hayward2007/desky/README.md

# desky

책상 위에 놓는 5자유도(5-DOF) 로봇팔 프로젝트. End-effector에 **휴대폰을 장착**하는 것이 목표이며,
DYNAMIXEL AX-18A 서보 5개를 시리얼로 제어하고 URDF 기반 순기구학(FK)/역기구학(IK)을 제공한다.
휴대폰 카메라를 통해 **얼굴/손/몸(어깨) 인식**(셋 다 휴대폰 브라우저 자체 MediaPipe Tasks
Vision — 몸 인식은 얼굴 인식 실패 시 폴백), **문서 스캔/요약**, **음성 대화**(Gemini)도
지원한다. 손 인식/가위바위보 제스처는 켜져 있지만, 팔이 손 위치로 움직이는 것(추종)만
기본 꺼짐(`FollowControllerConst.HAND_FOLLOW_ENABLED`).

> **이 저장소는 두 갈래를 하나로 합친 통합본이다.**
> · 팔 추적 계열 — 얼굴/손 추적, 추종 컨트롤러, 두리번거리기 (`desky-develop`)
> · 웹 기능 계열 — 일정(캘린더), 조명 제어, 가위바위보 제스처, 라즈베리파이 서버
>   (`desky-new_mobile_1017ver`)
> 두 계열이 서로를 막지 않고 동시에 돌아가도록 기능마다 객체를 분리했다.
> 무엇이 어디서 왔고 어떤 충돌을 어떻게 풀었는지는 [docs/MERGE.md](docs/MERGE.md),
> 함수 단위 설명은 [docs/FUNCTIONS.md](docs/FUNCTIONS.md) 참고.

## 하드웨어 / 관절 구성

- 액추에이터: DYNAMIXEL **AX-18A** × 5 (Protocol 1.0), U2D2 등으로 시리얼 연결
- 관절 축 구성 (base → tip):

  | id | 관절 | 축 | 역할 |
  | -- | ---- | -- | ---- |
  | 1 | yaw | Z | 베이스 회전 (방위) |
  | 2 | roll | X | 팔 평면 롤 |
  | 3 | pitch | Y | 어깨 |
  | 4 | pitch | Y | 팔꿈치 |
  | 5 | pitch | Y | 손목 |

- 5-DOF이므로 위치(x, y, z) + 부분적인 자세만 도달 가능하며, 임의의 6-DOF pose는 만족할 수 없다.
- AX-18A 물리 각도 범위: **0~300°**, 내부 유닛값 범위 0~1023.

## 시작하기

### 요구 사항

- Python 3.x (기구학 모듈은 표준 라이브러리 위주라 버전에 크게 구애받지 않음)
- 의존성은 [requirements.txt](requirements.txt)에 정리돼 있다:
  - `dynamixel_sdk`, `python-dotenv` — 하드웨어 제어 시에만 필요
  - `matplotlib` — [kinematics/simulate.py](kinematics/simulate.py) 3D 프리뷰 전용
  - `flask`/`flask-sock`/`pyopenssl` — [src/app.py](src/app.py) 제어 대시보드 + 모바일 카메라 스트리밍
  - `opencv-python`/`numpy` — 문서 검출, 카메라 미리보기 창
  - `google-genai` — Gemini 채팅/요약/STT/문서 읽기 (`/api/ask`, `/api/scan/parse`)
  - 얼굴/손/몸(어깨) 인식 자체는 서버 의존성이 아니다 — 휴대폰 브라우저가 MediaPipe
    Tasks Vision을 자체적으로 돌린다(아래 "얼굴/몸/손 인식" 절 참고). `mediapipe`(Python)는
    이 프로젝트에 필요 없다.
- 기구학 패키지(`kinematics/kinematics.py`, `urdf_loader.py`)는 **표준 라이브러리만** 사용 — numpy 등 불필요

```bash
python -m venv .venv
source .venv/bin/activate
pip install -r requirements.txt
```

각 기능 객체(하드웨어, Gemini)는 자기 의존성이 없어도 예외 없이 만들어지고
"그 기능만 비활성" 상태가 된다 — 위 의존성을 전부 설치하지 않아도 앱 자체는 항상 뜬다.

### 환경 변수

프로젝트 루트에 `.env` 파일이 필요하다.

```env
# 하드웨어 (실제 서보 제어 시에만 필요)
DEVICE_NAME=tty01        # /dev/ 접두어는 제외하고 작성
BAUDRATE=1000000
PROTOCOL_VERSION=1.0

# Gemini (채팅/요약/STT/문서 읽기 — 없으면 해당 기능만 비활성)
GEMINI_API_KEY=
```

## 파일 구조

하드웨어 제어(`hardware/`), 기구학+3D 프리뷰(`kinematics/`), AI 인지 기능(`perception/`),
웹 제어 대시보드(`src/`)를 별도 패키지로 분리했다. 서로 독립적이며, `fundamental/`(로거 +
상수)만 전체가 공통으로 참조하는 루트 패키지다.

```text
desky/
├── main.py             # 진입점 — src.app.run() 실행. 하드웨어 유무 무관
├── fundamental/         # 전체 공통 루트 패키지
│   ├── logger.py           # 공통 [TAG] message 콘솔 로거
│   ├── const.py            # 프로젝트 전역 상수 (.env 로딩도 여기서)
│   └── network.py          # 이 PC의 LAN 주소 자동 탐지 + 시작 배너/대시보드 안내
├── requirements.txt    # 전체 의존성
├── hardware/           # 시리얼/서보 제어 (실제 하드웨어 필요)
│   ├── controller.py
│   └── actuator.py
├── kinematics/         # FK/IK + 3D 프리뷰 (하드웨어 불필요)
│   ├── kinematics.py
│   ├── urdf_loader.py
│   ├── simulate.py
│   ├── mujoco_sim.py
│   ├── find_joint_limits.py
│   ├── configure/
│   │   ├── desky.urdf
│   │   ├── joints.json
│   │   └── manifest.json
│   └── meshes/*.stl
├── perception/         # AI 인지 기능 (하드웨어 불필요, 카메라 프레임/랜드마크 입력)
│   ├── camera_geometry.py
│   ├── face_tracker.py     # 좌표 변환만 — 인식은 휴대폰이 함
│   ├── hand_tracker.py     # 좌표 변환만 — 인식은 휴대폰이 함
│   ├── follow_controller.py
│   └── gesture.py          # 가위바위보 판정 (병합: 웹 기능 계열)
├── src/                # Flask 제어 대시보드 + 모바일 카메라/음성/문서/일정/조명
│   ├── app.py              # DeskyApp — 조립만 담당
│   ├── arm_service.py      # 팔 상태·하드웨어·안전 검사 (병합 시 전역 제거)
│   ├── render.py           # ArmRenderer / ScenePreview (3D 그림)
│   ├── perception_loop.py  # 카메라→인식→추종→미리보기 루프
│   ├── gesture_bridge.py   # 제스처 → 폰 명령 + 조명
│   ├── api/
│   │   ├── arm.py          # 팔 제어 라우트 (병합 시 app.py에서 분리)
│   │   ├── gemini.py
│   │   ├── camera.py       # 양방향 소켓 (프레임·음성·랜드마크 ↔ 명령)
│   │   ├── scan.py
│   │   ├── calendar.py     # 일정 저장소 (병합: 웹 기능 계열)
│   │   ├── light.py        # 조명 프록시 — 중계/직접 호출 자동 선택 (병합: 웹 기능 계열)
│   │   └── relay.py        # 인터넷 중계(ntfy.sh)로 파이에 조명 명령 전달
│   ├── static/
│   │   └── theme.css       # 공통 디자인 시스템(색·글꼴·버튼) — 모든 페이지가 링크
│   └── templates/
│       ├── index.html
│       ├── mobile.html     # 두 계열 UI를 합친 페이지 (/mobile)
│       └── calendar.html   # 한 달 달력 전용 화면 (/calendar)
├── raspberry-server/   # 파이에서 따로 실행하는 서보(조명) 서버 (병합: 웹 기능 계열)
│   ├── server.py
│   └── templates/index.html
└── docs/
    ├── FUNCTIONS.md    # 모듈·함수 단위 설명서
    ├── MERGE.md        # 병합 내역과 충돌 해결 기록
    ├── FEATURES.md     # 기능별 구현 원리 정리(발표용 재료)
    └── PRODUCT.md      # "이 제품이 왜 필요한가" 발표 자료용 정리
```

| 파일 | 역할 |
|---|---|
| [main.py](main.py) | 진입점 — `src.app.run()` 호출(`python main.py` → `https://localhost:8000`). 하드웨어 없어도 실행됨 |
| [fundamental/logger.py](fundamental/logger.py) | `Logger` — 모든 모듈이 공유하는 `[TAG] message` 콘솔 로거 |
| [fundamental/const.py](fundamental/const.py) | 프로젝트 전역 상수(AX-18A 컨트롤 테이블 포함) — 각 모듈이 여기서 import해서 씀. `.env` 로딩도 이 파일 맨 위에서(늦게 로드하면 값이 무시된다) |
| [fundamental/network.py](fundamental/network.py) | 이 PC의 공유기 내부 IP를 찾아 폰이 입력할 URL을 만든다(`server_urls`, `startup_banner`) |
| [hardware/controller.py](hardware/controller.py) | 시리얼 포트/보드레이트 초기화, 저수준 read/write (`set_speed`, `set_goal_position`, `get_present_position`) |
| [hardware/actuator.py](hardware/actuator.py) | `Actuator`(모터 1개 추상화) + `ArmController`(FK/IK ↔ Actuator 연동) |
| [kinematics/kinematics.py](kinematics/kinematics.py) | FK/IK. `Arm`/`Joint` + 순수 파이썬 선형대수. 하드웨어 불필요 |
| [kinematics/urdf_loader.py](kinematics/urdf_loader.py) | `configure/desky.urdf`를 파싱해 `Arm` 생성 (`xml.etree`) |
| [kinematics/simulate.py](kinematics/simulate.py) | 인터랙티브 FK 슬라이더 + IK 입력 3D 미리보기 (matplotlib) |
| [kinematics/configure/desky.urdf](kinematics/configure/desky.urdf) | **로봇 구성의 단일 소스 오브 트루스** (URDF, XML) |
| [perception/face_tracker.py](perception/face_tracker.py) | `FaceTracker` — **인식은 안 함**, 휴대폰이 보낸 얼굴 랜드마크를 3D 월드 좌표로 변환/시각화만 + `FaceFollower` |
| [perception/body_tracker.py](perception/body_tracker.py) | `BodyTracker` — **인식은 안 함**(얼굴 인식 실패 시 폴백), 휴대폰이 보낸 어깨 랜드마크를 3D 월드 좌표로 변환/시각화만 + `BodyFollower` |
| [perception/hand_tracker.py](perception/hand_tracker.py) | `HandTracker` — **인식은 안 함**, 휴대폰이 보낸 손 랜드마크를 end-effector FK 기반 3D 월드 좌표로 변환/시각화만 + `HandFollower` |
| [perception/follow_controller.py](perception/follow_controller.py) | `FollowController` — 얼굴>몸>손>idle 우선순위 + idle 두리번 상태 머신 |
| [perception/gesture.py](perception/gesture.py) | `GestureRecognizer` — 손 랜드마크로 가위/바위/보 판정, 확정 시 1회만 발동(엣지 트리거) |
| [src/app.py](src/app.py) | `DeskyApp` — **조립만** 담당(서비스 생성 + 라우트 등록 + 실행). 페이지 `/`, `/mobile` |
| [src/arm_service.py](src/arm_service.py) | `ArmService` — 팔 모델·하드웨어·관절각 캐시·자기충돌 안전 검사. 병합 전 `app.py` 전역이던 것 |
| [src/render.py](src/render.py) | `ArmRenderer`(자세→PNG) / `ScenePreview`(로컬 3D 창 재사용) |
| [src/perception_loop.py](src/perception_loop.py) | `PerceptionLoop` — 프레임→얼굴/손/몸→추종 명령→제스처→미리보기. 세 가지 주기를 따로 관리 |
| [src/gesture_bridge.py](src/gesture_bridge.py) | `GestureBridge` — 확정된 제스처를 폰 명령(소켓)과 조명 제어로 배선 |
| [src/api/arm.py](src/api/arm.py) | `ArmAPI` — 팔 제어 라우트(`/api/status`, `/fk`, `/ik`, `/render`, `/goto_*`) |
| [src/api/gemini.py](src/api/gemini.py) | `Gemini` — 채팅/요약(`/api/ask`), STT, 문서 이미지 글자 읽기 |
| [src/api/camera.py](src/api/camera.py) | `Camera` — `/ws/camera` **양방향**: 폰→서버(프레임·음성·손/얼굴/몸 랜드마크), 서버→폰(transcript·제스처 명령) |
| [src/api/scan.py](src/api/scan.py) | `ScanAPI` — `POST /api/scan/parse` 하나뿐. 라이브 프레임을 통째로 Gemini에 보내 읽는다(문서 검출/선택 없음) |
| [src/api/calendar.py](src/api/calendar.py) | `Calendar` — 일정 조회/추가/삭제(`/api/calendar/*`), `calendar_events.json`에 영속화 |
| [src/static/theme.css](src/static/theme.css) | 공통 디자인 시스템 — 색 토큰, 글꼴, 칩/큰버튼/입력 공통 스타일. 색 하나만 여기서 바꾸면 전 화면이 함께 바뀐다 |
| [src/templates/calendar.html](src/templates/calendar.html) | 일정 화면(`/calendar`) — 한 달 달력 + 고른 날의 일정 목록·추가 |
| [src/api/light.py](src/api/light.py) | `Light` — 조명 스위치 서보 프록시(`/api/light`). 폰의 혼합 콘텐츠 차단을 서버 경유로 우회. `Relay`가 켜져 있으면 인터넷 중계로, 아니면 직접 HTTP로 파이를 부른다 |
| [src/api/relay.py](src/api/relay.py) | `Relay` — PC와 파이가 서로 다른 공유기에 있어도 `ntfy.sh` 공개 중계소로 조명 명령을 전달(`DESKY_RELAY_TOPIC` 설정 시에만 활성) |
| [raspberry-server/server.py](raspberry-server/server.py) | 파이에서 **따로** 실행하는 서보 제어 서버 (`/api/press`) + `RelayClient`(중계 구독, 로컬 HTTP와 동시에 실행) |
| [src/templates/index.html](src/templates/index.html) | 대시보드 UI (위치/관절 입력, 상태, 카메라 프리뷰, 폰 접속 LAN 주소 카드) |
| [src/templates/mobile.html](src/templates/mobile.html) | 팔에 장착된 휴대폰에서 여는 페이지 — 카메라 스트리밍, Gemini 채팅/요약, 음성 대화·명령, 문서 스캔 UI |

> **항상 저장소 루트에서 실행할 것** (`python main.py`, `python -m kinematics.kinematics`,
> `python -m kinematics.simulate`, `python -m src.app` 등). 하위 폴더의 파일을 직접
> 실행하면(`python kinematics/kinematics.py`) 루트가 `sys.path`에 없어 `fundamental` 임포트가
> 깨진다.

### 계층 구조

```text
main.py
  └─ src.app.DeskyApp                       # 조립만: 서비스 생성 + 라우트 등록 + 실행
       ├─ src.arm_service.ArmService ── hardware.actuator.ArmController ── Actuator ×5 ── Controller ── fundamental.const.AX_18A + dynamixel_sdk
       │                                   └─ kinematics.kinematics.Arm ◄── kinematics.urdf_loader.load_arm()
       ├─ src.render.ArmRenderer            # URDF 기하 1회 파싱 → PNG / 3D 창
       ├─ src.api.arm.ArmAPI                # /api/status, /fk, /ik, /render, /goto_*
       ├─ src.api.gemini.Gemini             # /api/ask, STT, 문서 읽기
       ├─ src.api.camera.Camera ── Gemini   # /ws/camera (양방향)
       ├─ src.api.scan.ScanAPI ── Gemini     # 라이브 프레임 통째로 (문서 검출 없음)
       ├─ src.api.calendar.Calendar         # /api/calendar/*  (웹 기능 계열)
       ├─ src.api.light.Light ── Relay ──HTTP 또는 인터넷 중계──▶ raspberry-server  (웹 기능 계열)
       ├─ src.gesture_bridge.GestureBridge ── perception.gesture + Camera + Light
       └─ src.perception_loop.PerceptionLoop
            ├─ perception.face_tracker.FaceTracker        (폰이 보낸 랜드마크 → 월드 좌표)
            ├─ perception.body_tracker.BodyTracker        (폰이 보낸 랜드마크 → 월드 좌표, 얼굴 폴백)
            ├─ perception.hand_tracker.HandTracker        (폰이 보낸 랜드마크 → 월드 좌표)
            ├─ perception.follow_controller.FollowController  (얼굴 > 몸 > 손 > idle)
            └─ src.render.ScenePreview
```

병합 후 두 계열의 **유일한 접점**은 `Camera`(소켓)와 `ArmService`(팔 상태) 둘뿐이고,
둘 다 락으로 감싸져 있어 웹 요청 스레드와 카메라 루프가 안전하게 공유한다.

`main.py`는 `src.app`을 임포트해 실행하는 얇은 launcher다 — 실제 초기화(하드웨어, Gemini)는
`src/app.py` 쪽에서 일어난다 (하드웨어/Gemini가 없으면 실패를 잡아 "미연결/미구성" 상태로
대체 — 아래 절 참고).

`ArmController`가 FK/IK(`kinematics.Arm`)와 실제 `Actuator` 5개를 연결한다. `Actuator.id`
(DYNAMIXEL id)와 URDF `<dynamixel id="">`가 일치하는 조인트끼리 매칭하므로, 생성자에 넘기는
`actuators` 리스트는 순서에 상관없다.

```python
from hardware.controller import Controller
from hardware.actuator import Actuator, ArmController

controller = Controller()
actuators = [Actuator(id=i, model="AX-18A", controller=controller) for i in range(1, 6)]
arm_ctrl = ArmController(actuators)                  # arm=load_arm() 기본값 사용

q, ok = arm_ctrl.goto_position((0.3, 0.05, 0.15))    # IK 계산 → 5개 서보에 goto() 디스패치
pos = arm_ctrl.get_position()                         # 5개 서보 현재각 read → FK로 위치 계산
```

- `goto_position`은 IK가 수렴하지 않으면(`converged=False`) 서보를 움직이지 않는다.
- `get_position`은 액추에이터 중 하나라도 `None`을 반환하면(통신 실패) 전체 결과도 `None`.

## 웹 제어 대시보드 (하드웨어 없어도 실행됨)

```bash
python -m venv .venv && source .venv/bin/activate && pip install -r requirements.txt   # 최초 1회
python main.py   # 저장소 루트에서 실행, https://localhost:8000
# 또는 동일하게: python -m src.app
```

`src/app.py`는 시작 시 `Controller()`로 시리얼 포트를 열고 액추에이터 5개 + `ArmController`를
구성하려고 시도한다 — **성공하면** 실제 서보를 제어할 수 있고, **실패하면**(장치 없음,
`.env` 없음, `dynamixel_sdk`/`python-dotenv` 미설치 등) 예외를 잡아 "no hardware connected"
상태로 대시보드가 그대로 뜬다(아래 참고). 하드웨어가 연결되어 있으면 브라우저 대시보드에서:

- 관절별 서보각 슬라이더 → FK 미리보기가 실시간으로 갱신, "Move actuators"로 실제 이동
- 목표 위치 (x, y, z, 미터) 입력 → IK 계산, 슬라이더가 해로 스냅
- 1.5초마다 현재 위치를 폴링해 표시
- 팔에 장착된 휴대폰이 `/mobile`에서 스트리밍 중이면 카메라 프리뷰도 함께 표시(아래 참고)

라우트: `GET /`(대시보드), `GET /mobile`, `GET /api/status`, `POST /api/fk`, `POST /api/ik`,
`POST /api/render`, `POST /api/goto_position`, `POST /api/goto_joints`, `POST /api/goto_joint`,
`WS /ws/camera`, `GET /api/camera/latest.jpg`, `GET /api/camera/status`, `POST /api/ask`,
`POST /api/scan/parse`, `GET /api/network`(폰이 입력할 LAN 주소 목록).

> **참고:** `app.run(..., port=8000, debug=False, threaded=True, ssl_context="adhoc")`로
> 고정되어 있다.
>
> - 포트 5000이 아니라 8000을 쓰는 이유는 macOS AirPlay Receiver가 5000번을 기본으로 점유하기
>   때문.
> - `debug=False`인 이유는 Flask 리로더가 모듈을 다시 임포트하면 시리얼 포트가 두 번 열리기
>   때문 — `debug=True`로 바꾸지 말 것.
> - `threaded=True`인 이유는 `/ws/camera` 웹소켓이 세션 내내 연결을 유지해서, 스레드 하나로만
>   서빙하면 다른 HTTP 요청이 막히기 때문.
> - `ssl_context="adhoc"`인 이유는 아래 모바일 카메라 스트리밍 절 참고.

### 모바일 카메라 스트리밍 (`/mobile`, `/ws/camera`)

팔 끝(end-effector)에 장착된 휴대폰에서 `https://<이 서버의 LAN IP>:8000/mobile`을 열면:

1. "Start camera + streaming" 버튼을 누르면 `getUserMedia({video: {facingMode: {exact: "user"}},
   audio: false})`로 전면 카메라 권한을 요청한다(마운트 구조상 전면 카메라만 써야 하므로
   `exact`로 강제 — 전면 카메라가 없으면 후면으로 조용히 넘어가지 않고 바로 에러가 난다. 음성
   대화는 브라우저 내장 STT가 별도로 마이크 권한을 요청한다).
2. 승인되면 `<video>`로 로컬 프리뷰를 띄우고, 200ms(약 5fps)마다 `<canvas>`에 프레임을 그려
   `canvas.toBlob('image/jpeg')`로 JPEG를 만들어 `wss://<host>/ws/camera`로 바이너리 그대로
   전송한다. 프레임마다 완결된 JPEG라서 서버가 컨테이너/코덱을 재조립할 필요가 없다.

서버([src/api/camera.py](src/api/camera.py))는 `flask_sock.Sock`으로 `/ws/camera`를 raw
WebSocket으로 처리한다:

- 들어오는 바이너리가 JPEG면 최신 프레임으로 저장(락으로 보호), 프레임 수·마지막 수신 시각·
  연결된 클라이언트 수도 함께 추적. WebM/Opus 음성 클립이면 Gemini로 받아쓴다(레거시 경로 —
  현재 UI는 브라우저 내장 STT를 쓰므로 기본적으로는 이 경로를 타지 않는다).
- `GET /api/camera/latest.jpg` — 최신 프레임을 `image/jpeg`로 반환(아직 없으면 404).
- `GET /api/camera/status` — `{streaming, clients, frame_count, age_seconds}`.
- 대시보드(`/`)는 `/api/camera/status`를 0.5초마다 폴링하고, 스트리밍 중이면 이미지 태그를
  갱신해 실시간처럼 보여준다(진짜 스트리밍이 아니라 폴링 기반 프리뷰 — 데모 목적으로는 충분).

**HTTPS가 필요한 이유:** 브라우저는 secure context(HTTPS 또는 `localhost`)에서만
`getUserMedia`/음성 인식을 허용한다. 휴대폰은 LAN IP로 접속하므로 `localhost`가 아니어서
HTTPS가 필수다. `ssl_context="adhoc"`(pyOpenSSL)으로 실행할 때마다 자체 서명 인증서를 즉석에서
만들어 쓰므로 브라우저가 "안전하지 않음" 경고를 한 번 띄운다 — 데스크톱 대시보드, 모바일
페이지 둘 다에서 "고급 → 계속 진행"으로 넘어가야 한다.

### 얼굴/몸/손 인식 (`perception/face_tracker.py`, `perception/body_tracker.py`, `perception/hand_tracker.py`)

**얼굴/손/몸(어깨) 인식은 전부 휴대폰이 한다** — 컴퓨터 하나가 여러 모델 추론을 다
처리하면 매 프레임 렌더링/하드웨어 제어까지 합쳐서 휴대폰이 실제로 보내는 프레임레이트
(~20fps)를 못 따라갔고, 서버가 받는 프레임은 JPEG 압축 + 다운스케일 때문에 화질이 떨어져
인식 자체가 잘 안 되는 문제도 있었다(특히 얼굴). 그래서 `mobile.html`이 휴대폰 브라우저에서
직접 MediaPipe Tasks Vision(`HandLandmarker` + `FaceLandmarker` + `PoseLandmarker`)을
돌려 랜드마크만 `/ws/camera`로 보내고, 서버는 그 좌표를 3D 월드 좌표로 변환만 한다 —
mediapipe(Python)는 이 프로젝트에 필요 없다. 카메라 창에 얼굴/손/몸 골격을 오버레이하고,
3D 씬 창에도 추정 월드 좌표를 함께 그린다. 휴대폰 카메라가 end-effector에 달려 있다는
전제로, 기준자(손목~엄지CMC 3.5cm, 눈 바깥쪽 끝 사이 9cm, 양쪽 어깨 사이 0.4m)와 화면상
크기로 카메라까지 거리를 역산(핀홀 모델)한 뒤 현재 end-effector의 FK 변환행렬로 랜드마크를
월드 좌표에 올린다. 실제 캘리브레이션한 값이 아니므로 거리는 추정치다. 휴대폰이
HandLandmarker/FaceLandmarker/PoseLandmarker 중 하나를 못 띄우면(오프라인, CDN 접근 불가
등) 그 오버레이만 빠진다 — 서로 독립적으로 실패하며, 어느 쪽이든 카메라 창은 그대로 뜬다.
손 인식/가위바위보 제스처는 켜져 있다(`mobile.html`의 `HAND_TRACKING_ENABLED = true`) —
대신 팔이 손 위치로 움직이는 것(추종)만 서버 쪽
`FollowControllerConst.HAND_FOLLOW_ENABLED = False`로 기본 꺼져 있다. 손 인식 자체를
끄고 싶으면 `HAND_TRACKING_ENABLED`(둘 다 함께 꺼짐), 추종만 끄고 싶으면(제스처는 유지)
`HAND_FOLLOW_ENABLED`.

**몸(어깨) 인식은 얼굴 인식 실패 시 폴백이다** — 옆모습, 고개를 돌린 경우 등 얼굴이 안
잡힐 때도 어깨는 보이는 경우가 많다는 점을 이용한다. 처음엔 서버가 mediapipe Pose로
직접 돌렸지만(사용자가 명시적으로 요청했던 부분), 얼굴/손과 같은 이유로 이후 휴대폰으로
옮겼다. 양쪽 어깨 중점을 몸 중심으로 쓰고 어깨 너비(0.4m 가정)로 깊이를 추정하는 것
말고는 얼굴/손과 같은 핀홀 방식이고, 추종 로직(화면 오프셋 → yaw 회전 + 높이 이동)도
`FaceFollower`와 동일하다.

얼굴 > 몸 우선순위는 "보이느냐"가 아니라 **거리 기준**이다 — 얼굴까지 거리가
`FollowControllerConst.FACE_BODY_SWITCH_DISTANCE_M`(기본 1m)보다 가까우면 얼굴을, 멀면
(안 보여도) 몸을 추적한다. 멀리서는 얼굴 랜드마크가 화면에서 작아져 노이즈에 약해지는데
어깨는 상대적으로 안정적으로 잡히기 때문.

이 거리 경계에는 **히스테리시스**(`FACE_BODY_SWITCH_HYSTERESIS_M`, 기본 0.15m)를 둔다 —
경계 하나만 쓰면 깊이 추정치가 그 근처에서 맴돌 때(랜드마크 잔떨림, 고개를 살짝 돌리는
정도로도 흔함) 판정이 프레임마다 뒤집혀서, 디바운스가 있어도 몇 초에 한 번씩 계속
얼굴<->몸을 갈아타며 위아래로 훑는 진동이 남았다. 그래서 지금 얼굴을 보는 중이면 거리가
`FACE_BODY_SWITCH_DISTANCE_M + HYSTERESIS`보다 멀어져야 몸으로, 몸을 보는 중이면 그보다
`- HYSTERESIS`만큼 가까워져야 얼굴로 돌아온다(판정에 쓰는 얼굴 깊이 자체도
`FACE_DEPTH_SMOOTHING`으로 별도 평활).

대상 전환은 **디바운스**된다(`TARGET_SWITCH_TIMEOUT_S`, 기본 0.5초) — 인식이 한두
프레임 흔들릴 때마다 바로 갈아타면 코끝과 어깨 중점의 화면상 높이 차이 때문에 팔이
위아래로 계속 흔들리는 문제가 있어서, 새 후보가 그 시간 동안 끊기지 않고 이어져야
실제로 전환한다. **단 지금 얼굴을 추적 중일 때는** 이 시간 대신 더 긴
`FACE_LOST_GRACE_S`(기본 1.5초)를 쓴다 — 얼굴 인식은 고개를 살짝 돌리는 정도로도
한두 프레임 끊기는 일이 흔해서, 0.5초로는 몸으로 너무 쉽게 넘어가 버렸다. `FollowController`
우선순위는 얼굴 > 몸 > 손 > idle(히스테리시스 + 디바운스 반영).

**몸을 추적하며 멈춰 있으면 한 번 살짝 들어 올려 얼굴을 다시 찾아본다** — 몸(어깨)
추적 중 화면 오프셋이 데드존 안이라 팔이 `FACE_REACQUIRE_STILL_S`(기본 2초) 동안
가만히 있었고 거리가 가까우면(`FACE_BODY_SWITCH_DISTANCE_M` 이내), 팔을
`FACE_REACQUIRE_HEIGHT_STEP_M`만큼 한 번 들어 올려 얼굴이 화면에 걸리는지 시도해
본다 — 어깨 기준으로 카메라를 맞추면 얼굴이 화면 위쪽 경계 밖에 있을 수 있어서다.
들어 올린 뒤 `FACE_REACQUIRE_SUPPRESS_S` 동안은 `BodyFollower`가 다시 낮추지
못하게 붙잡아 두고, 몸 추적 세션당 한 번만 시도한다.

**전원을 켠 직후에는 카메라 연결과 무관하게 곧장 IDLE_POSITION으로 이동한다** —
`PerceptionLoop.__init__()`이 하드웨어가 연결돼 있으면 그 자리에서 바로 이동
명령을 낸다. 그 외 모든 이동은 카메라 프레임이 들어와야 도는
`FollowController.next_command()`를 거치므로, 이 이동만 따로 두지 않으면 폰이
아직 한 번도 연결 안 됐을 때 팔이 이전 세션 자세 그대로 계속 있게 된다.

**그 다음 `STARTUP_IDLE_S`(기본 3초) 동안은 무조건 idle을 유지한다** —
`FollowController`가 만들어진 시점부터 이 시간 동안은 얼굴/몸/손이 보여도 전부
무시한다. 카메라가 연결된 뒤에도 곧장 추적을 시작하지 않고 한 박자 쉬게 하는
용도로, 전원을 켜자마자 사람이 이미 카메라 앞에 있어도 그 순간 곧바로 팔이 홱
움직이지 않게 한다. 또한 `FollowController.next_command()`는 `camera_connected`
인자를 받는데(`PerceptionLoop`가 `Camera.connected()`로 넘겨준다), 이게 False면
idle이어도 두리번거리기(좌우로 흔드는 룩어라운드)는 시작하지 않고 IDLE_POSITION에서
가만히 대기만 한다 — 웹소켓은 붙어서 프레임이 흐르고 있어도 `mobile.html`의
Hand/Face/PoseLandmarker가 아직 로드 중이라 랜드마크를 한 번도 못 보낸 구간이
있는데, 그 구간을 "폰이 진짜 연결됐다"로 치지 않기 위해 `Camera.connected()`는
소켓 연결 + 랜드마크 최초 수신을 모두 요구한다.

### Gemini 채팅/요약/STT/문서 읽기 (`/mobile`, `POST /api/ask`)

[src/templates/mobile.html](src/templates/mobile.html)에 "Ask Gemini" 섹션이 있다
(대시보드 `/`에는 없음) — 텍스트를 입력하고 Chat/Summarize 모드를 골라 `POST /api/ask`로
보낸다. [src/app.py](src/app.py)는 하드웨어와 똑같은 패턴으로 시작 시 Gemini 클라이언트 구성을
시도하고, 실패해도 앱은 계속 뜬다:

- `GEMINI_API_KEY` 환경 변수(`.env`에 넣으면 `python-dotenv`가 있을 때 자동 로드됨)와
  `google-genai` 패키지가 있어야 `Gemini.configured`가 `True`가 된다.
- 실패하면(키 없음, 패키지 미설치 등) `Gemini.error`에 원인 저장 — `/mobile`은 "⚠ Gemini not
  configured — <원인>" 배너를 띄우고 입력/버튼을 비활성화한다.
- 답은 음성으로 그대로 읽히는 것을 전제로 짧고(100자 이내), 목록·기호·마크다운 없이 말하듯
  쓰도록 지시돼 있다.
- `POST /api/ask` — 바디 `{"text": "...", "mode": "chat"|"summary"}`. `mode`에 따라 다른
  system instruction을 사용해 Gemini를 호출한다.
  - 미구성 시 `503 {"error": "Gemini not configured: ..."}`.
  - `text` 누락 시 `400 {"error": "text is required"}`.
  - Gemini 호출 자체가 실패하면 `502 {"error": "..."}`.
  - 성공 시 `200 {"answer": "..."}`.

### 문서 스캔 · 요약 (`/mobile`, `POST /api/scan/parse`)

`/mobile`의 "문서 스캔" 버튼(또는 음성 "스캔해줘", 가위 제스처)을 누르면 지금
라이브로 들어오고 있는 카메라 프레임을 **통째로** Gemini에게 보내 본문을
읽는다 — `mode="text"`는 원문 그대로, `mode="summary"`는 짧게 요약해 TTS로
읽어준다. 별도의 문서 사각형 검출·원근 보정·선택 단계는 없다 — Gemini가
배경의 잡다한 글자는 무시하고 본문만 읽도록 프롬프트에서 지시한다. 원래는
OpenCV로 문서 사각형을 찾아 잘라낸 뒤 그 영역만 읽혔지만, 실사용에서는 이
검출 단계 없이 라이브 프레임을 그냥 보내는 것으로 충분해 걷어냈다.

### 음성 대화 · 음성 명령 (`/mobile`)

마이크 버튼("🎙 대화 시작")을 누르면 브라우저 내장 `SpeechRecognition`으로 연속 음성 인식을
시작한다(서버로 오디오를 보내지 않음). 5초간 말이 없으면 그때까지 들은 문장을 확정해:

- 알려진 명령("스캔해줘", "카메라 시작", "요약 모드로 바꿔", "N번 읽어줘", "대화 종료" 등)과
  일치하면 Gemini에 묻지 않고 그 기능을 바로 실행한다.
- 명령이 아니면 `/api/ask`로 Gemini에게 묻고, 답을 브라우저 TTS(`speechSynthesis`,
  한국어)로 읽어준 뒤 자동으로 다시 듣기 상태로 돌아간다 — 손을 쓰지 않고 계속 대화할 수 있다.

### 일정 / 캘린더 (`/mobile`, `/api/calendar/*`) — 웹 기능 계열

로봇 시야 화면(`/mobile`)의 **일정** 버튼을 누르면 한 달 달력이 화면 전체를 쓰는
`/calendar` 화면으로 넘어간다. 날짜 칸을 누르면 오른쪽에 그날 일정이 뜨고, 거기서
추가·삭제한다. `← 뒤로`가 `/mobile`로 되돌린다.

> 화면을 넘기는 동안에는 `/mobile`이 내려가므로 카메라와 웹소켓 세션도 함께 끊긴다
> (돌아오면 자동으로 다시 켜진다). 달력과 영상을 한 화면에 같이 두면 폰 크기에서
> 둘 다 작아지기만 해서 페이지를 나눴다 — 일정 화면에 머무는 동안은 팔 추적이 멈춘다.

음성으로도 된다:
"내일 오후 세시에 회의 추가해줘", "오늘 일정 뭐 있어", "오늘 며칠이야",
"이번 주 일정 알려줘", "삼월 오일 치과 예약 삭제".

**날짜 해석은 폰이, 저장은 서버가** 한다. "오늘/내일/다음 주 화요일"을 `YYYY-MM-DD`로
바꾸는 일은 전부 폰의 로컬 시계로 처리하고(`mobile.html` 7.5절, `calendar.html`), 서버
([src/api/calendar.py](src/api/calendar.py))는 확정된 날짜만 받는 순수 저장소다 —
서버와 폰의 시간대가 달라도 "오늘"이 어긋나지 않는다. 일정은 루트의
`calendar_events.json`에 임시파일→rename으로 원자적으로 저장된다(재시작해도 유지).

### 조명 제어 (`/mobile`, `/api/light`) — 웹 기능 계열

벽 스위치에 붙인 서보를 라즈베리파이가 눌러 불을 켜고 끈다. 폰이 파이를 **직접**
부르면 안 된다 — 이 페이지는 HTTPS이고 파이는 HTTP라 브라우저가 혼합 콘텐츠로
조용히 차단한다. 그래서 경로가 한 단계 더 있다:

```text
폰 ──HTTPS──▶ 이 서버 (/api/light) ──HTTP 또는 인터넷 중계──▶ raspberry-server (/api/press) ──PWM──▶ 서보
```

PC → 파이 구간은 자동으로 둘 중 하나로 갈린다:

- **직접 호출**(기본, 같은 공유기) — 환경변수 `PI_URL`로 바로 HTTP 호출.
- **인터넷 중계**(서로 다른 공유기) — PC의 `PI_URL`로는 파이에 닿을 수 없을 때(둘 다
  NAT 뒤), 양쪽에 같은 `DESKY_RELAY_TOPIC` 환경변수를 넣으면 [src/api/relay.py](src/api/relay.py)의
  `Relay`가 공개 pub/sub 서비스(`ntfy.sh`)를 거쳐 명령을 전달한다 — 포트포워딩·터널·
  고정 IP 없이 양쪽이 바깥으로 나가서 만난다. 주제 이름이 곧 비밀번호이므로 길고
  무작위하게 만들 것: `python -c "import secrets; print('desky-' + secrets.token_urlsafe(16))"`.
  `GET /api/light/status`가 지금 쓰는 경로(`route`)와 파이 생존 여부(`pi_alive`)를
  알려준다.

파이 쪽은 [raspberry-server/server.py](raspberry-server/server.py)를 파이에서 따로
실행한다(pigpio → lgpio → 모의 모드 자동 선택, GPIO 칩은 실제 점유 성공 여부로
판별). `DESKY_RELAY_TOPIC`을 설정하면 로컬 HTTP 서버와 중계 구독(`RelayClient`)이
동시에 뜬다. 파이가 꺼져 있어도 이 앱은 그대로 뜨고 조명 요청만 502로 실패한다.

### 폰이 접속할 주소 안내 (`fundamental/network.py`, `GET /api/network`)

서버는 `0.0.0.0`(모든 랜카드)에 바인딩되므로 같은 공유기의 폰은 이미 접속할 수
있는데, `0.0.0.0`은 주소창에 입력할 수 없고 `localhost`는 폰 자신을 가리켜 정작
입력해야 할 주소를 사람이 몰랐다. `network.py`가 UDP 소켓을 공인 주소로
`connect()`해(패킷은 안 나간다 — 커널 라우팅 테이블만으로 출발지 IP를 알아낸다) 이
PC의 실제 공유기 내부 주소를 찾고, 서버 시작 시 콘솔 배너로, 대시보드에서는
복사 버튼이 있는 카드로 보여준다.

### 가위바위보 제스처 (`/mobile`) — 두 계열이 만나는 지점

| 손모양 | 동작 |
|---|---|
| ✌️ 가위 | 문서 스캔 시작 |
| ✊ 바위 | 음성 대화 세션 시작 |
| ✋ 보 | 카메라 끄기 + 조명 끄기 |

인식·판정·실행 주체가 셋 다 다르다:

```text
폰(MediaPipe Tasks Vision로 손 인식)
   └─▶ 서버 perception.gesture (같은 모양 N프레임 유지 + 쿨다운으로 확정)
          └─▶ 폰 (카메라·마이크·화면이 거기 있으므로 실행은 폰이 한다)
```

폰이 올려 준 랜드마크 **하나**를 팔 추종(`FollowController`)과 제스처 판정이 함께
쓴다 — 그래서 손 인식이 두 번 돌지 않는다. `mobile.html`의 `HAND_TRACKING_ENABLED`를
false로 두면 손 추종과 제스처가 **함께** 꺼지고, 얼굴 추적과 idle 두리번거림, 버튼·음성
기능은 그대로 남는다. **제스처는 켜 둔 채 팔 추종만 끄고 싶으면** 이 스위치가 아니라
`fundamental.const.FollowControllerConst.HAND_FOLLOW_ENABLED`(기본값이 이미 `False`)를
쓴다 — 손은 계속 인식/전송되어 제스처는 그대로 동작하고, `FollowController`만 그 위치로
팔을 움직이지 않는다. 폰 화면의 "제스처 켬/끔" 버튼은 폰 쪽 실행만 막는 스위치다.

### 서버 로컬 카메라 미리보기 창 (`src.perception_loop.PerceptionLoop`)

`python main.py`와 `python -m src.app` 둘 다 [src/app.py](src/app.py)의 `run()` 함수 하나를
호출한다(중복 구현 방지). `run()`이 하는 일:

1. Flask 서버(`app.run(...)`)를 **백그라운드 스레드**로 띄운다 — `app.run()`은 영원히 블록되는
   호출이라, 메인 스레드에서 그대로 부르면 그 뒤 코드가 절대 실행되지 않는다.
2. 메인 스레드에서 `/ws/camera`로 들어온 최신 프레임을 얼굴/손/몸 인식 오버레이와 함께
   `cv2.imshow("Mobile camera", ...)`로, 로봇팔 3D 자세 + 인식된 얼굴/손/몸 위치를 "3D scene
   (robot + hand/face/body)" 창으로 서버가 실행 중인 컴퓨터 화면에 띄운다(이 미리보기 갱신은
   결정 루프보다 느리게 스로틀된다). **cv2 창 관련 호출은 반드시
   메인 스레드에서 실행해야 한다** — macOS에서는 OpenCV HighGUI가 메인 스레드가 아니면
   `imshow`/`waitKey`를 조용히 무시한다.
3. `cv2.waitKey(1)`로 HighGUI 이벤트 루프를 돌리면서(이게 없으면 창이 아예 갱신되지 않는다)
   `'q'`/Esc 입력 시 종료한다. `frame_count`가 실제로 바뀐 경우에만 디코드/표시하도록 체크한다
   — `waitKey(1)`은 "최대 1ms"일 뿐 보장이 아니라서, 이 체크가 없으면 휴대폰이 보내는 실제
   프레임(약 5fps)보다 훨씬 빠르게 같은 프레임을 반복 디코드/표시하게 된다.

### 하드웨어 미연결 시 동작

`hardware.controller`/`hardware.actuator` 임포트 자체(즉 `dynamixel_sdk` 누락 포함)부터
`Controller()`/`ArmController()` 생성까지 전부 `src/app.py`의 `try/except Exception` 안에
있다. 실패하면 `arm_ctrl = None`이 되고:

- 대시보드 페이지는 그대로 렌더링되지만 "⚠ No hardware connected — <원인>" 배너가 뜨고 모든
  입력/버튼이 `disabled` 처리된다 (조인트 목록만 `kinematics.urdf_loader.load_arm()`로 별도
  로드해서 보여준다).
- `GET /api/status` → `{"connected": false, "error": "..."}` (200, 에러 아님).
- `POST /api/goto_position`, `POST /api/goto_joints`, `POST /api/goto_joint` →
  `503 {"error": "no hardware connected"}`.

## 3D 시뮬레이션 (하드웨어 없이 미리보기)

```bash
python -m venv .venv && source .venv/bin/activate && pip install -r requirements.txt   # 최초 1회
python -m kinematics.simulate   # 저장소 루트에서 실행
```

[kinematics/simulate.py](kinematics/simulate.py)는 `kinematics.urdf_loader.load_arm()`으로
로봇 형상([kinematics/configure/desky.urdf](kinematics/configure/desky.urdf))을 읽어 인터랙티브
3D 창을 띄운다. 관절마다 서보각 슬라이더가 있어 움직이면 FK로 자세가 즉시 갱신되고, x/y/z를
입력해 IK를 풀면 슬라이더가 해로 스냅된다. 웹 대시보드의 `/api/render`도 이 파일의
`draw_pose`/`workspace_bounds`를 그대로 재사용한다.

> **참고:** `kinematics/simulate.py`는 서보각을 URDF의 `<limit>`(IK용 소프트 리미트)로
> 클램프하지 않는다 — 실제 `Actuator.goto()`도 물리 범위(0~300°) 안이면 그 리미트를 무시하고
> 그대로 움직이므로, 시뮬레이션도 동일하게 동작해야 "실제 로봇과 정확히 같은" 모션이 된다.

메시 기반(정확한 형상) 시뮬레이션이 필요하면 `python -m kinematics.mujoco_sim`(MuJoCo 필요,
선택 의존성).

## 기구학 사용법

```python
from kinematics.urdf_loader import load_arm
arm = load_arm()                        # kinematics/configure/desky.urdf에서 구성 로드 (권장)
# 또는: from kinematics.kinematics import Arm; arm = Arm()   # 하드코딩 fallback

pos = arm.fk([0, 0, 0, 0, 0])            # 관절각(rad) → end-effector 위치(x, y, z)
q, ok = arm.ik(target_pos)               # 위치 IK (damped least-squares)
q, ok = arm.ik(target_pos, target_rot=R3x3)  # 자세 포함(best-effort)
servo_deg = arm.q_to_servo_deg(q)         # 관절각(rad) → 서보각(0~300°)
```

- IK는 수렴 여부를 `bool`로 반환하며, 도달 불가능한 목표에 대해서도 예외 없이 `False`를 반환한다.
- 관절각 `q`(rad, home 기준) ↔ 서보각(deg) 변환: `servo_deg = home_deg + direction * degrees(q)`.

### 하드웨어 없이 검증하기

저장소 루트에서 실행:

```bash
python -m kinematics.kinematics     # FK/IK 라운드트립 self-test
python -m kinematics.urdf_loader    # URDF 로드 + FK/IK 라운드트립
```

기대 결과: `converged=True`, 위치 오차 < 1mm.

## 로봇 구성 수정 방법

로봇 치수·서보 캘리브레이션을 바꿀 때는 코드가 아니라
**[kinematics/configure/desky.urdf](kinematics/configure/desky.urdf) 하나만 수정**한다.
`urdf_loader`가 이를 읽어 `Arm`을 구성한다.

- 링크 길이 → 각 `<joint>`의 `<origin xyz>` (URDF 관례상 **미터** 단위)
- 관절 한계 → `<limit lower upper>` (라디안)
- 축 → `<axis xyz>`
- DYNAMIXEL id/모델/서보 캘리브레이션 → 프로젝트 확장 태그
  `<dynamixel id="" model="" home_deg="" direction="">` (표준 URDF 툴은 무시하고, `urdf_loader`만 읽음)

## 주의사항 / 알려진 특성

- `hardware/controller.py`의 read/write는 통신·하드웨어 에러가 나도 **예외로 죽지 않고**
  경고를 출력한 뒤 계속 진행한다. `set_*` 계열은 성공 여부를 `bool`로, `get_present_position`은
  실패 시 `None`을 반환하므로 **호출부에서 반드시 `None`을 처리**해야 한다.
- `Controller`는 `with Controller() as c:` 형태의 컨텍스트 매니저를 지원한다 (GC에 맡기지
  않고 포트를 결정적으로 정리).
- 각도 ↔ 유닛 변환은 `/360` 계수를 사용한다 (물리 범위 0~300°는 리미트로 의도적으로 처리됨 —
  변경하지 말 것).
- URDF를 직접 편집할 때 XML 주석 안에 `--`(이중 하이픈)를 넣으면 파싱 에러가 나므로 주의.
- `Gemini`는 하드웨어와 같은 "부분 실패" 패턴을 따른다 —
  의존성이 없어도 앱 전체가 죽지 않고 그 기능만 비활성화된다. (`FaceTracker`/`HandTracker`/
  `BodyTracker`는 이 패턴이 아니다 — 인식 자체를 안 하므로 서버 쪽엔 `available` 개념이
  없다. 셋 다 실패 지점은 `mobile.html`의 Hand/Face/PoseLandmarker 로드 쪽으로 옮겨갔다.)
- 모든 모듈의 콘솔 출력은 `logger.Logger.log(tag, message)`를 거쳐 `[TAG] message` 형식으로
  통일된다. `Logger.enabled` 플래그 하나로 전체 로그를 끌 수 있다.
