hayward2007/desky/docs/PRODUCT.md

# 이 제품이 2035년에 필요한 이유 — 발표 자료용 정리

발표 대본이 아니라 **재료**다. 주장 하나마다 근거와 시연 방법을 붙여 두었고,
아직 약한 부분은 §7에 따로 모아 두었으니 발표 전에 그쪽을 먼저 볼 것.

---

## 1. 한 줄 메시지

> **지금까지는 사람이 기기 앞으로 갔다. 데스키는 기기가 사람 앞으로 온다.**

슬라이드 한 장을 이 문장만으로 채워도 된다. 나머지는 전부 이 문장의 각주다.

---

## 2. 문제 — 본론에 닿기까지 매번 내는 비용

지금의 모든 작업에는 본론 이전에 **준비 과정**이 붙는다.

```
폰을 집는다 → 잠금을 푼다 → 앱을 찾는다 → 화면을 터치한다 → 그제서야 본론
└────────────────── 작업과 무관한 고정 비용 ──────────────────┘
```

이 준비 과정은 하려는 일 자체와 아무 상관이 없는데도 매번 지불해야 한다.
젊고 익숙한 사용자에게는 몇 초짜리 성가심이지만, 뒤에서 보듯 어떤 사용자에게는
**작업을 포기하게 만드는 문턱**이 된다.

발표에서는 이 개념에 이름을 붙여 두면 이후 슬라이드가 편해진다 — **"진입 비용"** 정도.

---

## 3. 전환 — 준비 과정을 없앤다

데스키는 사람이 준비를 마칠 때까지 기다리지 않는다. **먼저 사람을 주시하다가**
작은 말과 몸짓을 포착해 곧바로 실행한다.

| | 기존 | 데스키 |
|---|---|---|
| 시작하는 쪽 | 사람 | 기기 |
| 사람이 하는 일 | 기기를 찾아가 조작 | 평소처럼 말하고 움직임 |
| 필요한 학습 | 앱 위치, 메뉴 구조 | 없음 |

원래 메모의 "찾아가는 서비스를 오프라인에 투사"는 뜻은 정확하지만 한 번에 꽂히지
않는다. 발표용으로는 이 쪽을 권한다:

> 복지관이 어르신을 기다리지 않고 찾아가듯, 인터페이스가 사람을 찾아온다.

---

## 4. 근거 ① — 고령자에게는 비용이 아니라 장벽이다

타이핑과 화면 조작은 세 가지 능력을 동시에 요구한다.

1. 작은 글씨를 읽는 시력
2. 정확한 위치를 짚는 손의 정밀도
3. 메뉴 구조를 기억하는 인지력

**셋 다 나이가 들며 가장 먼저 약해지는 능력**이다. 그래서 고령층에게 스마트 기기는
"조금 불편한 것"이 아니라 "못 쓰는 것"이 된다.

데스키가 요구하는 것은 **말 한마디와 손짓 하나**뿐이다. 외울 메뉴 구조가 없고,
정확히 짚어야 할 좌표도 없다. 손바닥을 펴 보이는 동작 하나가 곧 명령이다.

---

## 5. 근거 ② — IoT는 이미 연결됐지만, 사람과의 접점은 그대로다

가전끼리는 이미 연결되어 있다. 그런데 **사람과 그 연결망 사이의 접점은 여전히
폰 화면**이다. 기기가 늘어날수록 앱도 늘어나 오히려 조작이 복잡해지는 역설이 있다.

데스키는 연결망을 새로 만들지 않는다. **이미 있는 연결망의 입구**를 사람 쪽으로
옮긴다.

> **은유는 하나만 쓸 것.** 원래 메모의 "관제탑"과 "전초기지"가 섞이면 상이 흐려진다.
> 데스키는 위에서 내려다보며 통제하는 관제탑보다, 사람 곁에 붙어 있는 **창구**에 가깝다.

### 여기서 오히려 강점이 되는 지점

현재 조명 제어는 스마트 전구를 API로 부르는 방식이 **아니다**. 라즈베리파이에 붙은
서보가 **벽에 달린 물리 스위치를 직접 누른다**(`raspberry-server/`, `src/api/light.py`).

기술적으로는 투박해 보이지만 발표에서는 이 편이 강하다:

> 스마트 가전이 아니어도 조작할 수 있다. 즉 **집을 새로 바꾸지 않아도 된다.**

고령 가구일수록 가전이 오래됐다는 점을 생각하면, IoT 표준을 못 따르는 낡은 기기까지
포섭한다는 것은 약점이 아니라 이 제품의 적용 범위다. 다만 §7의 주의사항도 함께 볼 것.

---

## 6. 왜 하필 2035년인가

원래 메모에는 이 답이 없었다. 아래 숫자가 그 자리를 채운다.

| 지표 | 수치 | 출처 |
|---|---|---|
| 65세 이상 인구 비중 | 2022년 17.4% → 2025년 20.3% → **2036년 30.9%** → 2050년 40% 초과 | 통계청 장래인구추계(2023.12 공표) |
| 같은 지표(직전 추계) | 2025년 20%, **2035년 30%**, 2050년 40% 돌파 | 통계청 장래인구추계 2020~2070 |
| 독거노인 수 | 2015년 137.9만 → 2025년 224.8만 → **2035년 342.9만** | 한국보건사회연구원(2015) — 오래된 추계라 재확인 권장 |

발표용 한 문장으로 압축하면:

> **2035년경 국민 셋 중 하나가 65세 이상이 된다.**
> 그중 상당수는 곁에서 대신 봐줄 사람 없이 혼자 산다.

두 번째 줄이 중요하다. 고령화만 말하면 "그래서 요양 시설"로 흘러가지만, **혼자 산다**를
붙이면 "집 안에서 스스로 해결할 수단"이라는 이 제품의 자리가 생긴다.

> 발표 직전에 통계청 장래인구추계·장래가구추계에서 최신 수치를 한 번 더 확인할 것.
> 위 표의 독거노인 수치는 2015년 자료라 지금은 값이 달라졌을 가능성이 있다.

---

## 7. 예상 반박 — 미리 준비해야 하는 두 가지

### 반박 1. "그거 AI 스피커로 이미 되지 않나요?" ← 가장 먼저 나온다

답은 **눈과 몸을 가졌다는 것**이다.

| | AI 스피커 | 데스키 |
|---|---|---|
| 입력 | 말만 | 말 + 몸짓 + 시야 |
| 사용자 위치 | 모름 (사람이 스피커 쪽으로 말해야) | 얼굴을 찾아 따라감 |
| 말이 어려울 때 | 방법 없음 | 손짓으로 지시 |
| 눈앞의 종이 | **불가능** | 직접 보고 읽어줌 |

**마지막 줄이 가장 강력하다.** 어르신이 받은 고지서를 책상에 놓기만 하면 로봇이
스스로 그것을 보고 읽어 요약해 주는 장면 — 스피커로는 원리적으로 불가능하다.
반박이 나오면 설명하지 말고 이 장면을 시연할 것.

### 반박 2. "카메라가 계속 보고 있는 게 부담스럽지 않나요?"

질문을 기다리지 말고 먼저 꺼내는 편이 낫다. 설계 단계에서 이미 답이 있다.

- **손 인식은 폰 안에서 끝나고 좌표 21개만 서버로 간다** — 손 영상이 밖으로 나가지 않는다
  (`perception/hand_tracker.py`, `mobile.html` 10번 절)
- 얼굴 인식과 문서 인식은 **로컬 PC**에서 처리한다 — 외부 클라우드로 상시 전송하지 않는다
- 손바닥을 펴 보이면 카메라가 즉시 꺼진다 — **끄는 방법이 가장 쉬운 동작**이다

마지막 항목이 특히 설득력 있다. 프라이버시 스위치를 메뉴 깊숙이 두지 않고 **가장 단순한
제스처**에 배정했다는 것은 사후 변명이 아니라 설계 우선순위의 증거다.

> 다만 정직하게 말할 것: 카메라 자체는 켜져 있는 동안 계속 프레임을 보낸다.
> "영상이 전혀 나가지 않는다"고 말하면 틀린 말이 된다. 나가지 않는 것은 **손 영상**이고,
> 얼굴·문서 프레임은 같은 네트워크 안의 PC로 간다.

---

## 8. 시연 각본 — 주장과 구현의 대응

주장마다 실제로 돌아가는 기능을 붙여 두면 설득력이 다르다. 아래는 전부 구현되어 있다.

| 순서 | 주장 | 시연 | 구현 위치 |
|---|---|---|---|
| 1 | 사람을 주시한다 | 자리를 옮기면 팔이 따라온다 | `perception/follow_controller.py` |
| 2 | 아무도 없으면 스스로 찾는다 | 시야에서 벗어나면 두리번거린다 | 같은 파일 (idle 상태) |
| 3 | 준비 과정 없이 지시 | 손바닥 한 번 → 카메라·조명 정지 | `perception/gesture.py` |
| 4 | **스피커가 못 하는 일** | 책상 위 서류를 읽고 요약해 말해줌 | `perception/document_scanner.py` + `src/api/gemini.py` |
| 5 | 낡은 가전도 조작 | 말 한마디로 벽 스위치를 물리적으로 누름 | `src/api/light.py` + `raspberry-server/` |
| 6 | 기억을 대신함 | "내일 세시에 병원" → 일정 등록 | `src/api/calendar.py` |

**순서를 4번에 걸어라.** 1~3번은 "신기하다"에서 끝나지만 4번은 "필요하겠다"로 넘어간다.
시간이 부족하면 1번과 4번만 해도 된다.

---

## 9. 아직 약한 곳 — 발표 전에 채울 것

1. **로봇팔이어야 하는 이유가 아직 한 줄로 없다.** 고정 카메라 여러 대로도 비슷한 걸
   할 수 있다는 반문이 가능하다. 현재 준비된 답은 *"사람이 기기에 자세를 맞추지 않아도
   된다"* 정도인데, 더 강한 근거가 필요하다. 문서 스캔이 힌트가 될 수 있다 — 팔이
   움직여야 책상 위 임의의 위치에 놓인 종이를 정면에서 볼 수 있다.
2. **독거노인 통계가 2015년 자료다.** 발표 전 최신 장래가구추계로 교체할 것.
3. **비용과 설치 형태를 아무도 안 물어보진 않는다.** "책상에 놓는가, 천장에 다는가",
   "얼마인가"에 한 줄씩은 준비해 둘 것.
4. **§5의 물리 스위치 방식은 양날이다.** "왜 스마트 전구를 안 쓰나"라는 질문이 함께
   온다. 답은 "둘 다 된다 — 스마트 기기는 API로, 아닌 기기는 물리적으로"가 되어야 하는데,
   현재 구현된 것은 물리 스위치 쪽뿐이다. 있는 것과 계획인 것을 섞어 말하지 말 것.

---

## 10. 표현 점검

| 쓰지 말 것 | 대신 |
|---|---|
| "찾아가는 서비스를 오프라인에 투사" | "인터페이스가 사람을 찾아온다" |
| "관제탑"과 "전초기지"를 함께 | 하나만 — 권장은 "창구" |
| "혁신적인", "획기적인" | 무엇이 달라지는지 문장으로 |
| "AI 기술을 활용하여" | 무슨 일을 하는지로 (읽어준다, 따라온다) |
| "노인분들도 쉽게" | 왜 쉬운지 (외울 메뉴가 없다) |

시연 중에 기술 이름을 말하지 말 것. 청중이 기억하는 것은 **팔이 따라오는 장면**과
**종이를 읽어주는 장면**이지 mediapipe나 IK가 아니다.
