hayward2007/desky/kinematics/meshes/bracket_f5.stl

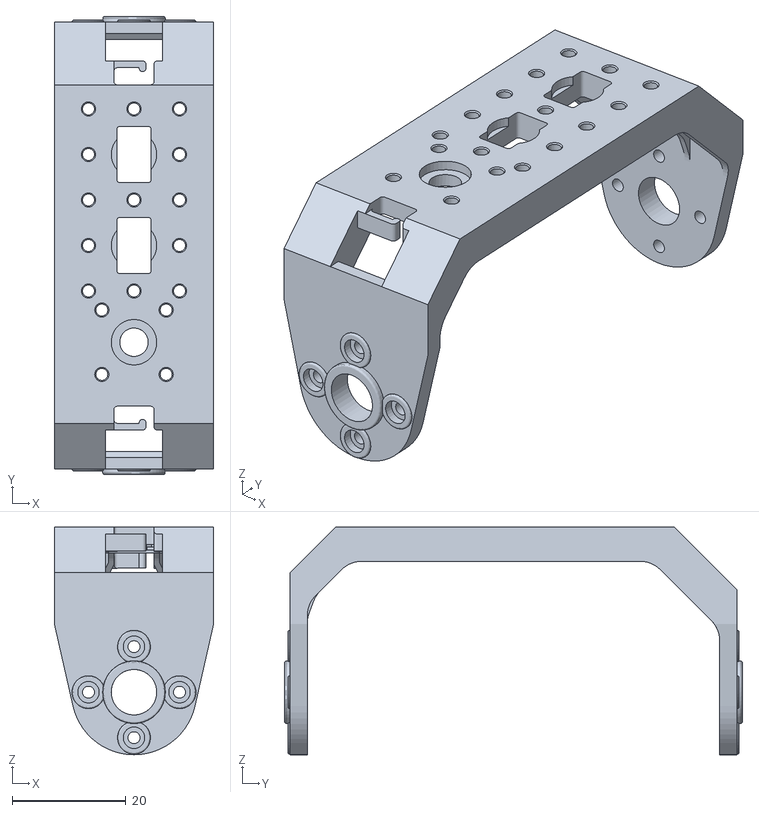
[picture p1: CAD file, 2026-07-24]
kinematics/meshes/bracket_f5.stl
28.0 x 80.5 x 40.0
