hayward2007/desky/kinematics/meshes/end_effector.stl

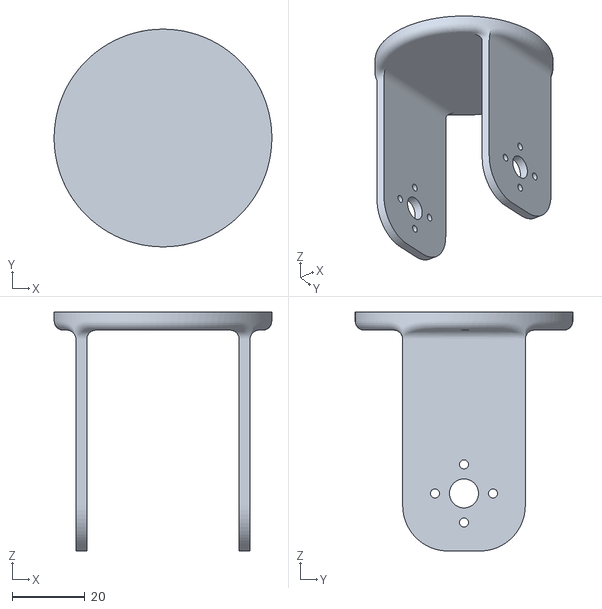
[picture p2: CAD file, 2026-07-24]
kinematics/meshes/end_effector.stl
60.0 x 60.0 x 65.9
