hayward2007/desky/kinematics/meshes/gaurd.stl

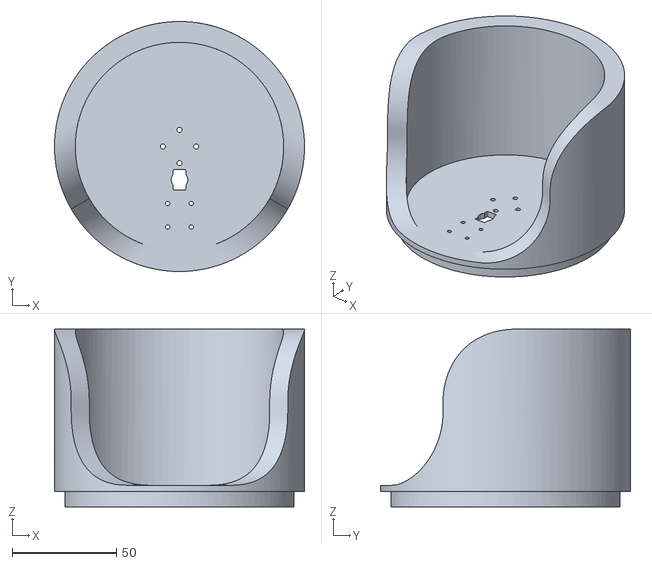
[picture p3: CAD file, 2026-07-24]
kinematics/meshes/gaurd.stl
120.0 x 120.0 x 85.4
