hayward2007/desky/kinematics/meshes/link.stl

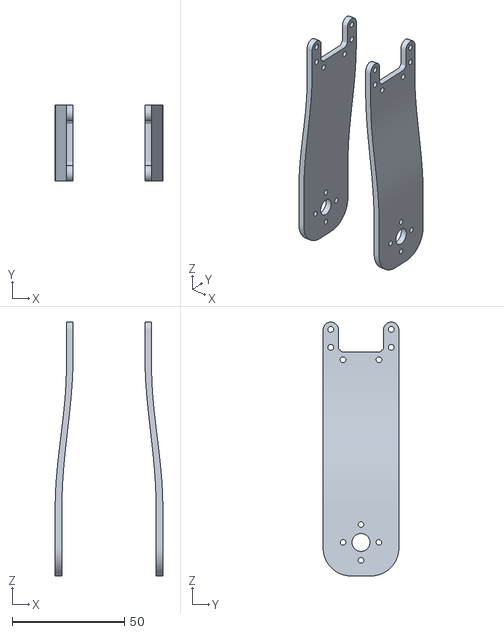
[picture p4: CAD file, 2026-07-24]
kinematics/meshes/link.stl
48.0 x 33.8 x 113.3
