hayward2007/desky/kinematics/meshes/dynamixel.stl

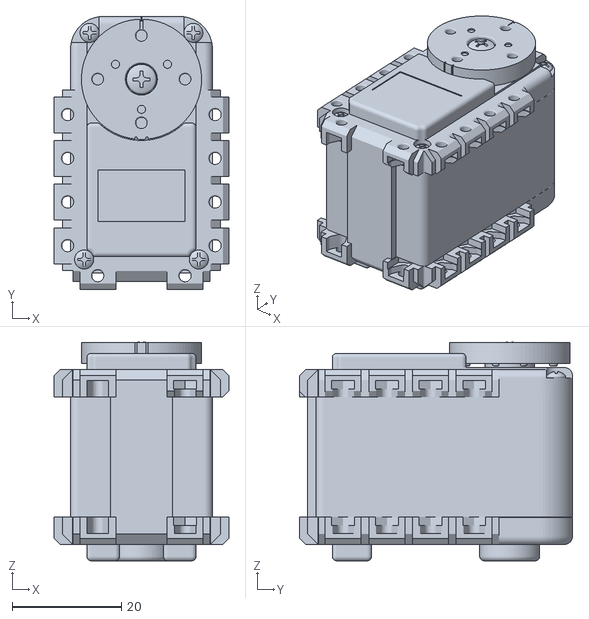
[picture p5: CAD file, 2026-07-24]
kinematics/meshes/dynamixel.stl
32.0 x 50.0 x 40.0
