hayward2007/desky/kinematics/meshes/base.stl

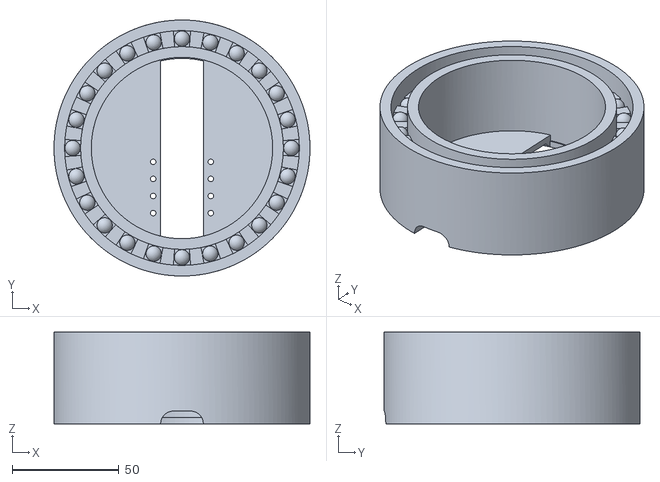
[picture p6: CAD file, 2026-07-24]
kinematics/meshes/base.stl
120.0 x 120.0 x 43.0
