hayward2007/desky/kinematics/meshes/bracket_f6.stl

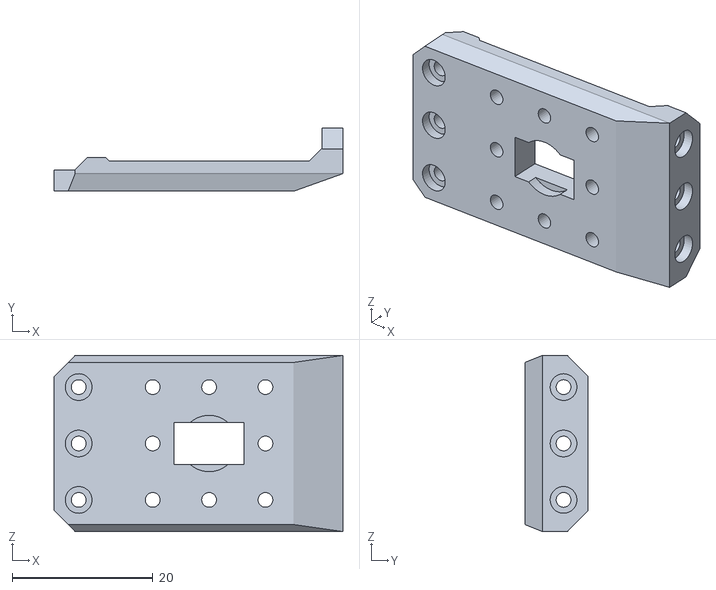
[picture p7: CAD file, 2026-07-24]
kinematics/meshes/bracket_f6.stl
41.0 x 9.00 x 25.0
