hayward2007/desky/(commit log)

2026-07-14 feat: added motor control
2026-07-21 feat: added kinematics
2026-07-22 feat: added urdf
    [desky.urdf]
2026-07-22 refactor: resturctured folder hierarchy
    [desky.urdf]
2026-07-22 feat: added camera websocekt
2026-07-22 modify: urdf corrected
    [desky.urdf]
2026-07-22 feat: added inverse kinematics to web
    [desky.urdf]
2026-07-22 reafactor: refactored app.py
    [desky.urdf]
2026-07-22 feat: added mediapipe hands
    [desky.urdf]
2026-07-23 feat: added mujoco
    [base.stl, bracket_f5.stl, bracket_f6.stl, desky.urdf, dynamixel.stl, end_effector.stl, gaurd.stl, link.stl]
2026-07-23 modify: corrected kinematics
    [desky.urdf]
2026-07-23 feat: added cam orientation correction
    [desky.urdf]
2026-07-23 feat: added advanced face track
